icl-rocketry/payload_gimbal/motorboard/motorboard_back.png

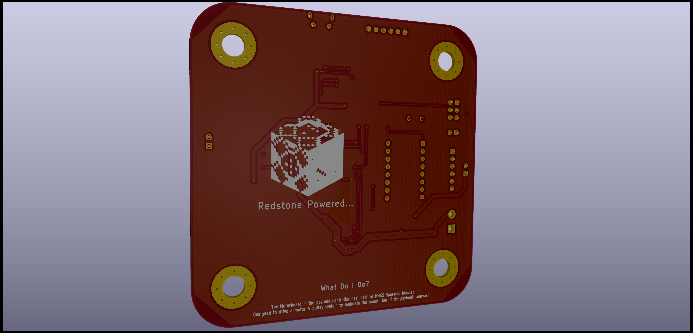
motorboard/motorboard_back.png
