icl-rocketry/payload_gimbal/motorboard/motorboard_cool.png

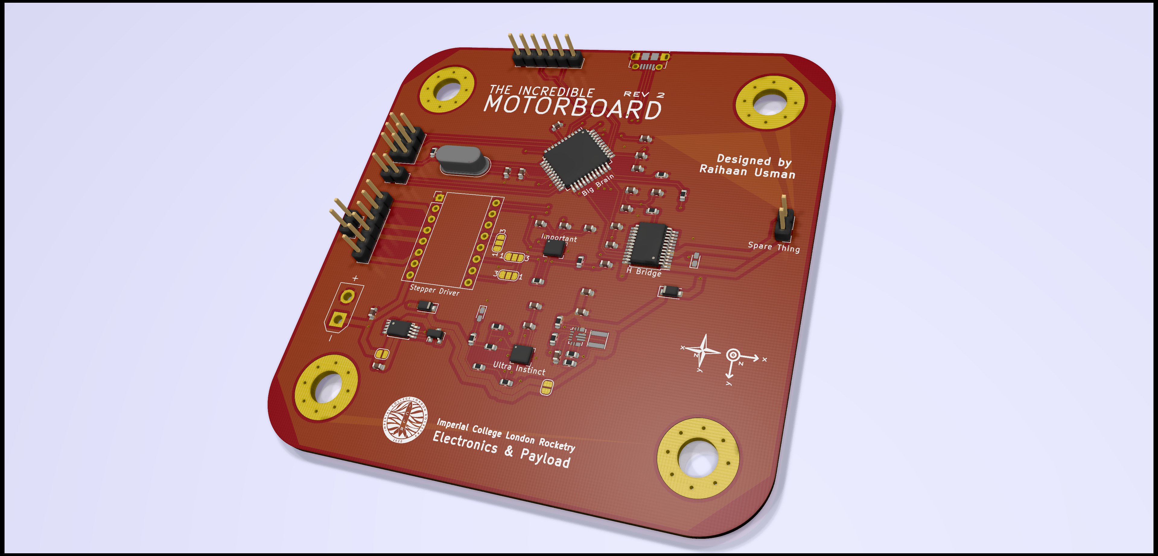
motorboard/motorboard_cool.png
