icl-rocketry/payload_gimbal/motorboard/References/microcontroller-sticker-pinout-atmega32u4.png

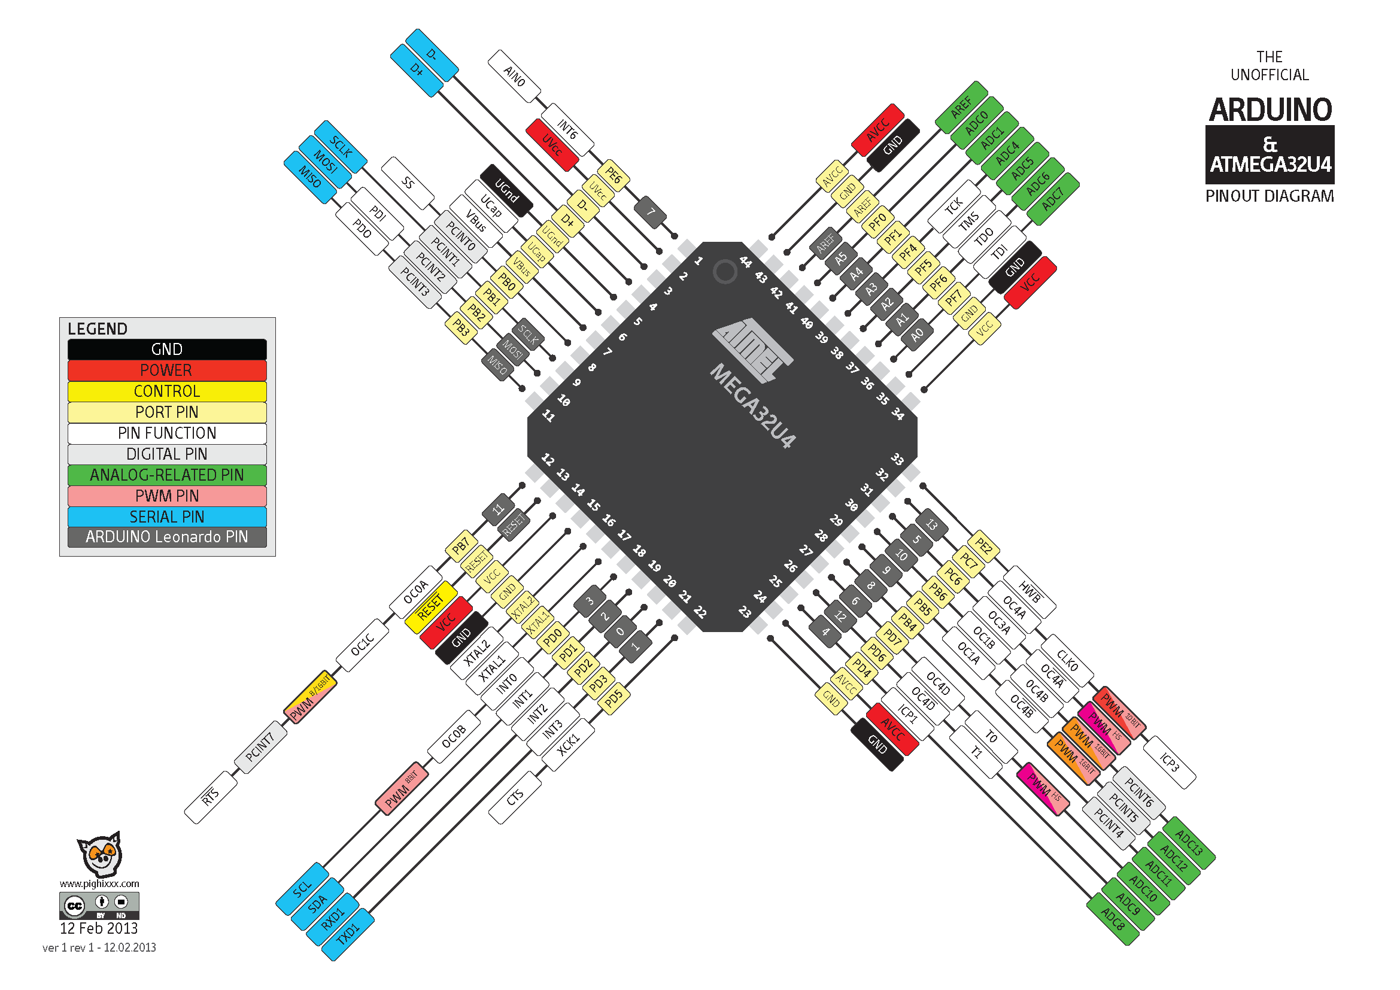
motorboard/References/microcontroller-sticker-pinout-atmega32u4.png
