icl-rocketry/payload_gimbal/motorboard/BOM for Motorboard.xlsx

Id | Designator | Package | Quantity | Designation | Unit Price | Farnell Order Code | Digikey Part Nr | URL | Total Price
4 | Y1 | Crystal_HC18-U_Vertical | 1 | 8MHz | £0.35 | 1842268 |  | https://uk.farnell.com/txc/9b-8-000maaj-b/xtal-8-000mhz-18pf-hc-49s/dp/1842268 | £0.35
9 | U2 | TQFP-44_10x10mm_P0.8mm | 1 | ATmega32U4-AU | £3.17 | 1748525 |  | https://uk.farnell.com/microchip/atmega32u4-au/mcu-8bit-megaavr-16mhz-tqfp-44/dp/1748525 | £3.17
12 | J2 | USB_Micro-B_Molex-105017-0001 | 1 | USB_B_Micro | £0.67 | 2293836 |  | https://uk.farnell.com/molex/105017-0001/usb-conn-2-0-micro-usb-type-b/dp/2293836 | £0.67
13 | U6,U5 | LGA-24L_3x3.5mm_P0.43mm | 2 | LSM9DS1 | £5.26 | 2532383 |  | https://uk.farnell.com/stmicroelectronics/lsm9ds1tr/mems-accelero-gyroscope-magneto/dp/2532383?st=LSM9DS1 | £10.52
14 | U4 | Texas_PowerVFQFN_15 | 1 | TPS63070 | £2.26 | 3007465 |  | https://uk.farnell.com/texas-instruments/tps63070rnmr/dc-dc-conv-buck-boost-2-4mhz-vqfn/dp/3007465?st=TPS63070 | £2.26
15 | U3 | TSSOP-8_4.4x3mm_P0.65mm | 1 | TPS2412PW | £2.47 | 2383048 |  | https://uk.farnell.com/texas-instruments/tps2412pw/o-ring-controller-3v-16-5v-tssop/dp/2383048?ost=TPS2412PW | £2.47
16 | U1 | SSOP-24_5.3x8.2mm_P0.65mm | 1 | TB6612FNG |  |  |  |  | £0.00
17 | R15,R14,R13,R12,R8,R5,R1 | R_0603_1608Metric | 7 | 10k | £0.01 | 1469748RL |  | https://uk.farnell.com/vishay/crcw060310k0fkea/res-10k-1-0-1w-0603-thick-film/dp/1469748RL?st=10k | £0.10
18 | R11 | R_0603_1608Metric | 1 | 150k | £0.01 | 1469759 |  | https://uk.farnell.com/vishay/crcw0603150kfkea/res-150k-1-0-1w-0603-thick-film/dp/1469759?st=150k | £0.01
19 | R10 | R_0603_1608Metric | 1 | 470k | £0.30 | 2331232 |  | https://uk.farnell.com/te-connectivity/cpf0603b470ke1/res-470k-0-1-0-063w-0603-thin/dp/2331232 | £0.30
20 | R9 | R_0603_1608Metric | 1 | 100k | £0.03 | 9234250 |  | https://uk.farnell.com/yageo/rc0805jr-07100kl/res-100k-5-0-125w-0805-thick-film/dp/9234250 | £0.03
21 | R7,R6 | R_0603_1608Metric | 2 | 470R | £0.02 | 9233334 |  | https://uk.farnell.com/yageo/rc0603jr-07470rl/res-470r-5-0-1w-0603-thick-film/dp/9233334 | £0.04
22 | R4 | R_0603_1608Metric | 1 | 10K | £0.01 | 1469748RL |  | https://uk.farnell.com/vishay/crcw060310k0fkea/res-10k-1-0-1w-0603-thick-film/dp/1469748RL?st=10k | £0.01
23 | R3,R2 | R_0603_1608Metric | 2 | 4k7 | £0.28 | 1577615 |  | https://uk.farnell.com/panasonic/era3aeb472v/res-4k7-0-1-0-1w-0603-thin-film/dp/1577615 | £0.56
24 | Q1 | SOT-23 | 1 | PMV20ENR | £0.30 |  | 1727-2301-1-ND | https://www.digikey.co.uk/product-detail/en/nexperia-usa-inc/PMV20ENR/1727-2301-1-ND/5395603 | £0.30
25 | L1 | L_Taiyo-Yuden_NR-30xx | 1 | 1u5 | £0.15 | 2211176 |  | https://uk.farnell.com/tdk/c1608x5r1e155k080ab/cap-1-5-f-25v-10-x5r-0603/dp/2211176 | £0.15
37 | D4,D3 | D_SOD-123F | 2 | D_Schottky | £0.12 |  | 1655-1926-1-ND | https://www.digikey.co.uk/product-detail/en/smc-diode-solutions/DSS13UTR/1655-1926-1-ND/8341868 | £0.24
40 | C22,C21,C19,C17,C16,C14,C10,C5 | C_0603_1608Metric | 10 | 100n | £0.05 | 1657913 |  | https://uk.farnell.com/avx/02016d104kat2a/cap-0-1-f-6-3v-10-x5r-0201/dp/1657913?st=100n | £0.49
41 | C20,C15,C12,C11,C9,C8,C1 | C_0603_1608Metric | 10 | 10u | £0.12 | 2456110 |  | https://uk.farnell.com/murata/grm188r61a106me69d/cap-10-f-10v-20-x5r-0603/dp/2456110 | £1.22
42 | C18,C13 | C_0603_1608Metric | 10 | 10n | £0.04 | 1657919 |  |  | £0.41
43 | C7 | C_0603_1608Metric | 10 | 2.2n | £0.08 | 1658869 (https://uk.farnell.com/avx/06035c223kat2a/cap-0-022-f-50v-10-x7r-0603/dp/1658869?st=0603%2022000pf) |  | https://uk.farnell.com/avx/06035c223kat2a/cap-0-022-f-50v-10-x7r-0603/dp/1658869?st=0603%2022000pf | £0.81
44 | C6 | C_0603_1608Metric | 10 | 1u | £0.08 | 2470448 (https://uk.farnell.com/murata/grm033r60j105mea2d/cap-1-f-6-3v-20-x5r-0201/dp/2470448) |  | https://uk.farnell.com/murata/grm033r60j105mea2d/cap-1-f-6-3v-20-x5r-0201/dp/2470448 | £0.85
45 | C4,C3 | C_0603_1608Metric | 10 | 22p | £0.02 | 2434636 (https://uk.farnell.com/murata/grm0335c1e220ja01d/cap-22pf-25v-5-c0g-np0-0201/dp/2434636) |  | https://uk.farnell.com/murata/grm0335c1e220ja01d/cap-22pf-25v-5-c0g-np0-0201/dp/2434636 | £0.16
46 | C2 | C_0603_1608Metric | 5 | 47u | £0.91 | 1572633 (https://uk.farnell.com/kemet/c0805c476m9pactu/cap-47-f-6-3v-20-x5r-0805/dp/1572633) |  | https://uk.farnell.com/kemet/c0805c476m9pactu/cap-47-f-6-3v-20-x5r-0805/dp/1572633 | £4.57
 |  |  |  |  |  |  |  | Total | £29.68
