icl-rocketry/payload_gimbal/motorboard/board.dxf

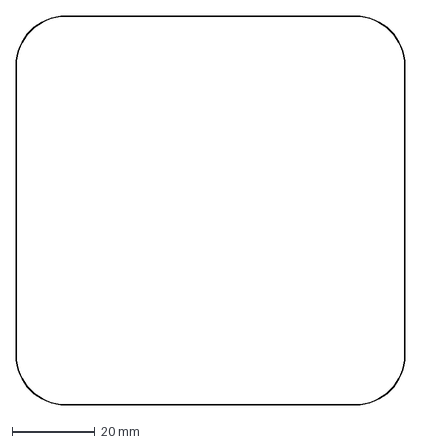
[picture p4: CAD file, 2020-03-26]
motorboard/board.dxf
94.0 x 94.0 mm
