icl-rocketry/payload_gimbal/motorboard/motorboard.kicad_pcb

## KiCad design motorboard/motorboard.kicad_pcb (2020-03-26)

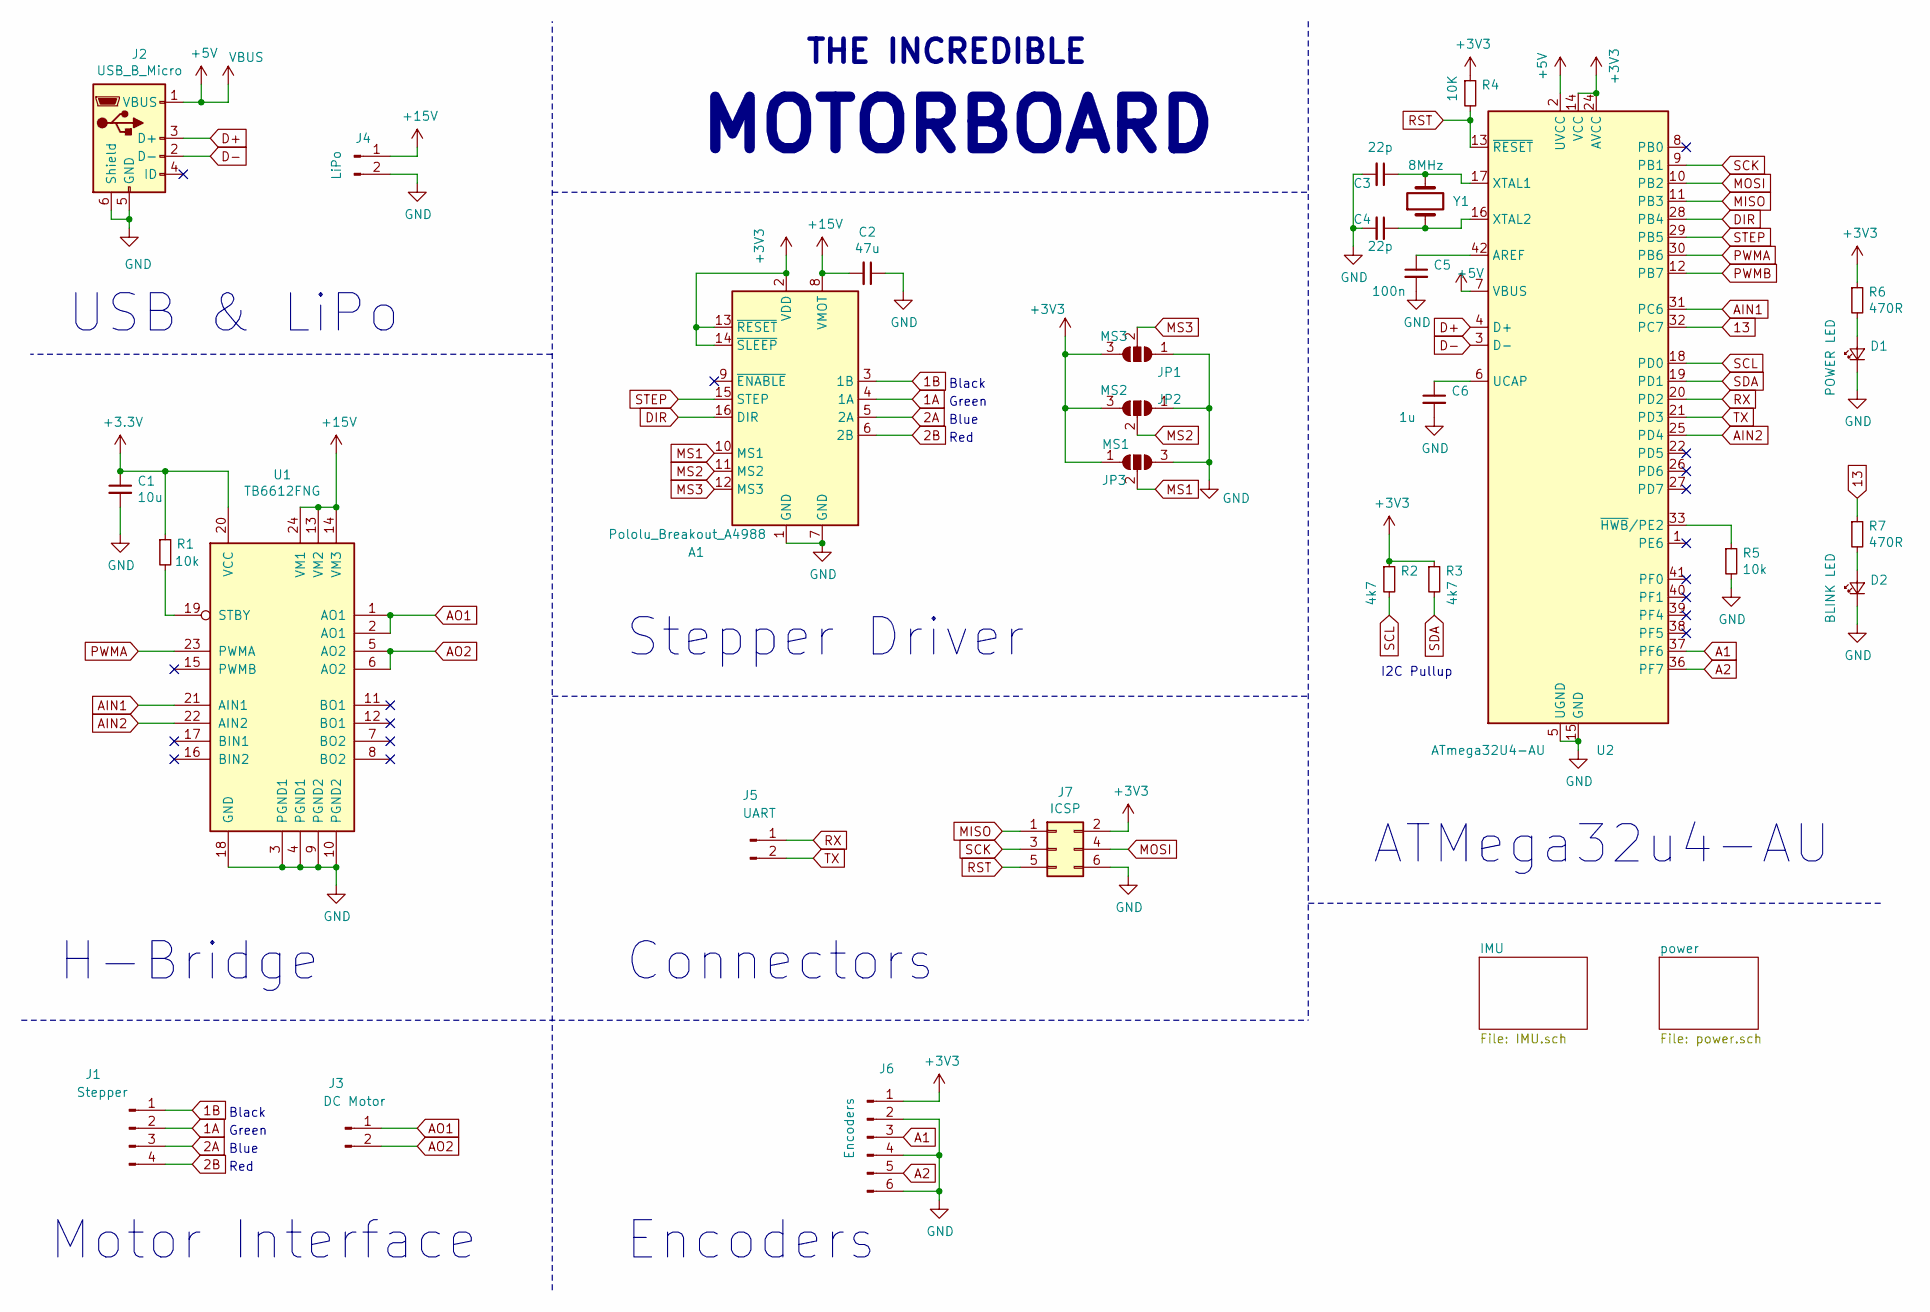
[picture p5: schematic motorboard.sch, The Incredible Motorboard]

Parts:
A1: Pololu_Breakout_A4988; Pololu_Breakout-16_15.2x20.3mm
C1: 10u; C_0603_1608Metric
C2: 47u; C_0603_1608Metric
C3, C4: 22p; C_0603_1608Metric
C5: 100n; C_0603_1608Metric
C6: 1u; C_0603_1608Metric
D1: POWER LED; D_0603_1608Metric_Castellated
D2: BLINK LED; D_0603_1608Metric_Castellated
J1: Stepper; PinHeader_1x06_P2.54mm_Vertical
J2: USB_B_Micro; USB_Micro-B_Molex-105017-0001
J3: DC Motor; PinHeader_1x02_P2.54mm_Vertical
J4: LiPo; AMASS_XT30UPB-F_1x02_P5.0mm_Vertical
J5: UART; PinHeader_1x02_P2.54mm_Vertical
J6: Encoders; PinHeader_1x06_P2.54mm_Vertical
J7: ICSP; PinHeader_2x03_P2.54mm_Vertical
JP1: MS3; SolderJumper-3_P1.3mm_Open_RoundedPad1.0x1.5mm_NumberLabels
JP2: MS2; SolderJumper-3_P1.3mm_Open_RoundedPad1.0x1.5mm_NumberLabels
JP3: MS1; SolderJumper-3_P1.3mm_Open_RoundedPad1.0x1.5mm_NumberLabels
R1, R5: 10k; R_0603_1608Metric
R2, R3: 4k7; R_0603_1608Metric
R4: 10K; R_0603_1608Metric
R6, R7: 470R; R_0603_1608Metric
U1: TB6612FNG; SSOP-24_5.3x8.2mm_P0.65mm
U2: ATmega32U4-AU; TQFP-44_10x10mm_P0.8mm
Y1: 8MHz; Crystal_HC49-4H_Vertical

Connections:
1A: A1.4 (1A), J1.2
1B: A1.3 (1B), J1.1
2A: A1.5 (2A), J1.3
2B: A1.6 (2B), J1.4
13: R7.1, U2.32 (PC7)
+5V: J2.1 (VBUS), U2.2 (UVCC), U2.7 (VBUS); also elsewhere on the board
+15V: A1.8 (VMOT), C2.2, J4.1, U1.13 (VM2), U1.14 (VM3), U1.24 (VM1); also elsewhere on the board
A1: J6.3, U2.37 (PF6)
A2: J6.5, U2.36 (PF7)
AIN1: U1.21 (AIN1), U2.31 (PC6)
AIN2: U1.22 (AIN2), U2.25 (PD4)
AO1: J3.1, U1.1 (AO1), U1.2 (AO1)
AO2: J3.2, U1.5 (AO2), U1.6 (AO2)
D+: J2.3 (D+), U2.4 (D+)
D-: J2.2 (D-), U2.3 (D-)
DIR: A1.16 (DIR), U2.28 (PB4)
GND: A1.1 (GND), A1.7 (GND), C1.2, C2.1, C3.2, C4.2, C5.2, C6.2, D1.1 (K), D2.1 (K), J2.5 (GND), J2.6 (Shield), J4.2, J6.2, J6.4, J6.6, J7.6, JP1.1 (A), JP2.1 (A), JP3.3 (B), R5.2, U1.3 (PGND1), U1.4 (PGND1), U1.9 (PGND2), U1.10 (PGND2), U1.18 (GND), U2.5 (UGND), U2.15 (GND), U2.23 (GND), U2.35 (GND), U2.43 (GND); also elsewhere on the board
MISO: J7.1, U2.11 (PB3)
MOSI: J7.4, U2.10 (PB2)
MS1: A1.10 (MS1), JP3.2 (C)
MS2: A1.11 (MS2), JP2.2 (C)
MS3: A1.12 (MS3), JP1.2 (C)
unnamed: C3.1, U2.17 (XTAL1), Y1.2
unnamed: C4.1, U2.16 (XTAL2), Y1.1
unnamed: C5.1, U2.42 (AREF)
unnamed: C6.1, U2.6 (UCAP)
unnamed: D1.2 (A), R6.2
unnamed: D2.2 (A), R7.2
unnamed: R1.2, U1.19 (STBY)
unnamed: R5.1, U2.33 (~HWB~/PE2)
PWMA: U1.23 (PWMA), U2.30 (PB6)
PWMB: U2.12 (PB7)
RST: J7.5, R4.2, U2.13 (~RESET)
RX: J5.1, U2.20 (PD2)
SCK: J7.3, U2.9 (PB1)
SCL: R2.2, U2.18 (PD0); also elsewhere on the board
SDA: R3.2, U2.19 (PD1); also elsewhere on the board
STEP: A1.15 (STEP), U2.29 (PB5)
TX: J5.2, U2.21 (PD3)

Notes on the sheet:
H-Bridge
USB & LiPo
ATMega32u4-AU
Motor Interface
Encoders
MOTORBOARD
THE INCREDIBLE
I2C Pullup
Stepper Driver
Black
Green
Blue
Red
Connectors

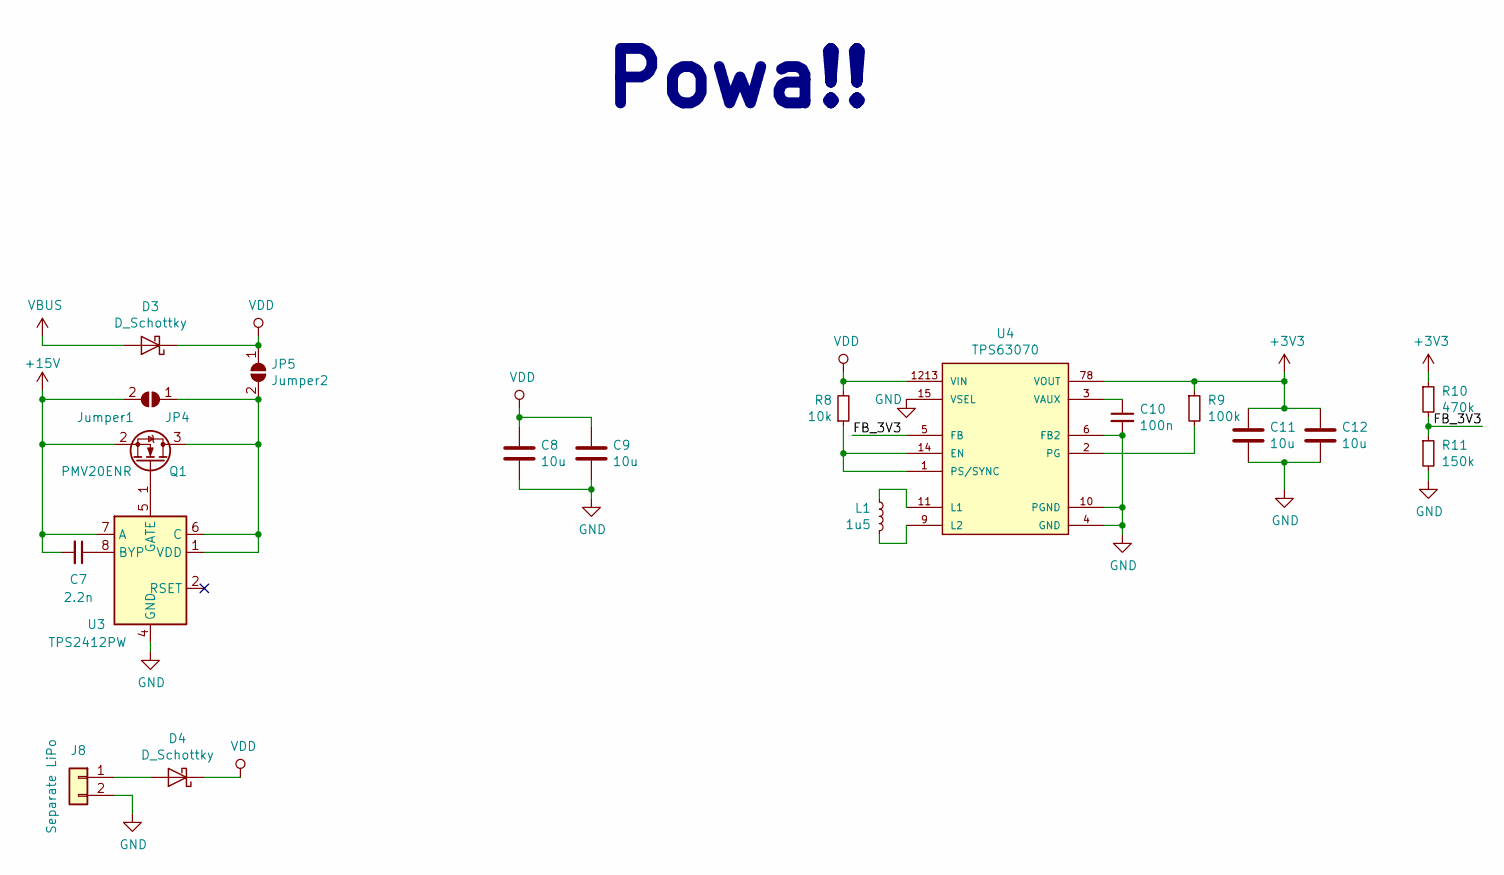
[picture p6: schematic power.sch]

Parts:
C7: 2.2n; C_0603_1608Metric
C8, C9, C11, C12: 10u; C_0603_1608Metric
C10: 100n; C_0603_1608Metric
D3, D4: D_Schottky; D_SOD-123F
J8: Separate LiPo; PinHeader_1x02_P2.54mm_Vertical
JP4: Jumper1; SolderJumper-2_P1.3mm_Open_RoundedPad1.0x1.5mm
JP5: Jumper2; SolderJumper-2_P1.3mm_Open_RoundedPad1.0x1.5mm
L1: 1u5; L_Taiyo-Yuden_NR-30xx
Q1: PMV20ENR; SOT-23
R8: 10k; R_0603_1608Metric
R9: 100k; R_0603_1608Metric
R10: 470k; R_0603_1608Metric
R11: 150k; R_0603_1608Metric
U3: TPS2412PW; TSSOP-8_4.4x3mm_P0.65mm
U4: TPS63070; Texas_PowerVFQFN_15

Connections:
+5V: D3.2 (A); also elsewhere on the board
+15V: C7.2, JP4.2 (B), Q1.2 (S), U3.7 (A); also elsewhere on the board
/power/FB_3V3: R10.2, R11.1, U4.5 (FB)
GND: C8.2, C9.2, C10.2, C11.2, C12.2, J8.2, R11.2, U3.3 (GND), U3.4 (GND), U4.4 (GND), U4.6 (FB2), U4.10 (PGND), U4.15 (VSEL); also elsewhere on the board
unnamed: C7.1, U3.8 (BYP)
unnamed: C10.1, U4.3 (VAUX)
unnamed: D4.2 (A), J8.1
unnamed: JP4.1 (A), JP5.2 (B), Q1.3 (D), U3.1 (VDD), U3.6 (C)
unnamed: L1.1, U4.9 (L2)
unnamed: L1.2, U4.11 (L1)
unnamed: Q1.1 (G), U3.5 (GATE)
unnamed: R8.1, U4.1 (PS/SYNC), U4.14 (EN)
unnamed: R9.2, U4.2 (PG)
VDD: C8.1, C9.1, D3.1 (K), D4.1 (K), JP5.1 (A), R8.2, U4.1213 (VIN)

Notes on the sheet:
Powa!!

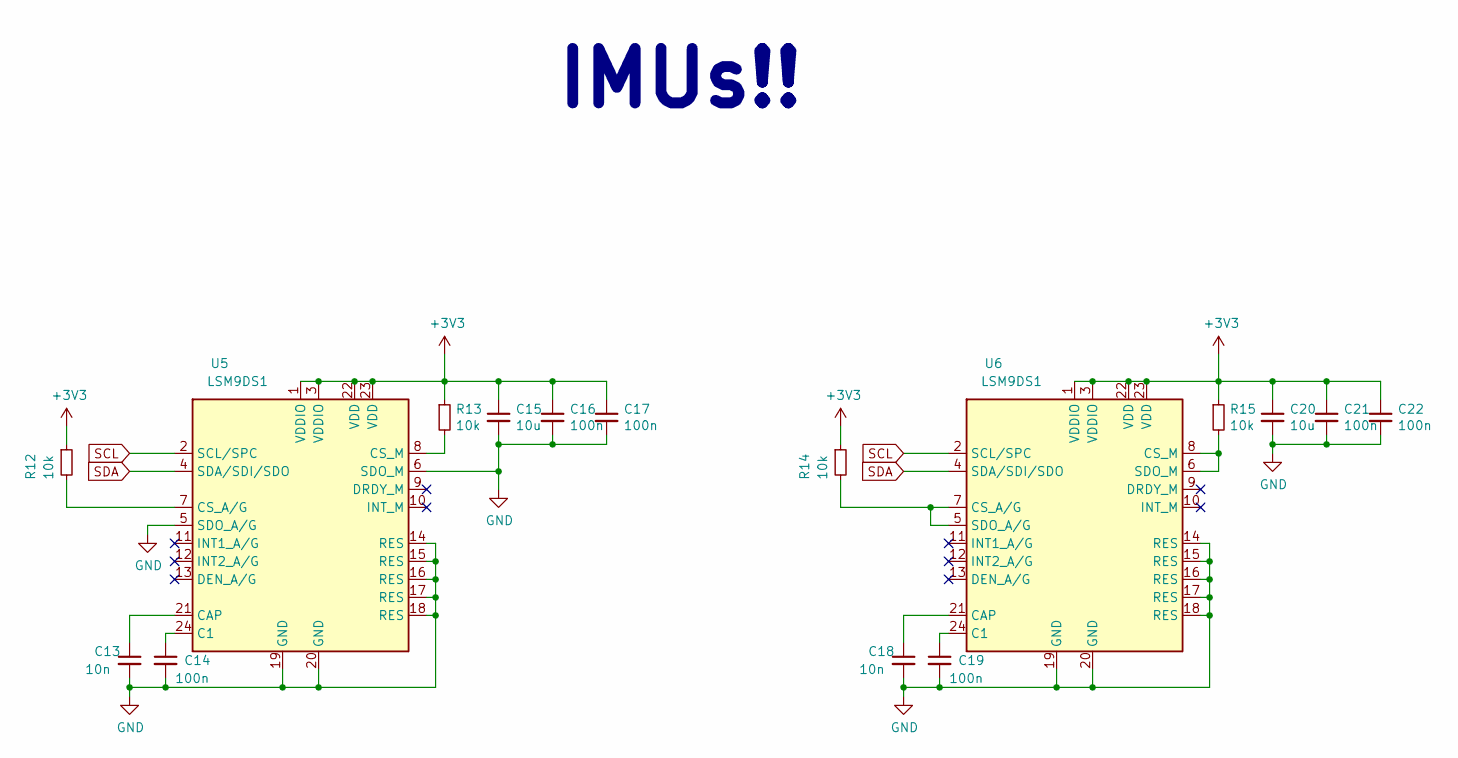
[picture p7: schematic IMU.sch, IMUs]

Parts:
C13, C18: 10n; C_0603_1608Metric
C14, C16, C17, C19, C21, C22: 100n; C_0603_1608Metric
C15, C20: 10u; C_0603_1608Metric
R12, R13, R14, R15: 10k; R_0603_1608Metric
U5, U6: LSM9DS1; LGA-24L_3x3.5mm_P0.43mm

Connections:
GND: C13.2, C14.2, C15.2, C16.2, C17.2, C18.2, C19.2, C20.2, C21.2, C22.2, U5.5 (SDO_A/G), U5.6 (SDO_M), U5.14 (RES), U5.15 (RES), U5.16 (RES), U5.17 (RES), U5.18 (RES), U5.19 (GND), U5.20 (GND), U6.14 (RES), U6.15 (RES), U6.16 (RES), U6.17 (RES), U6.18 (RES), U6.19 (GND), U6.20 (GND); also elsewhere on the board
unnamed: C13.1, U5.21 (CAP)
unnamed: C14.1, U5.24 (C1)
unnamed: C18.1, U6.21 (CAP)
unnamed: C19.1, U6.24 (C1)
unnamed: R12.2, U5.7 (CS_A/G)
unnamed: R13.2, U5.8 (CS_M)
unnamed: R14.2, U6.5 (SDO_A/G), U6.7 (CS_A/G)
unnamed: R15.2, U6.6 (SDO_M), U6.8 (CS_M)
SCL: U5.2 (SCL/SPC), U6.2 (SCL/SPC); also elsewhere on the board
SDA: U5.4 (SDA/SDI/SDO), U6.4 (SDA/SDI/SDO); also elsewhere on the board

Notes on the sheet:
IMUs!!

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
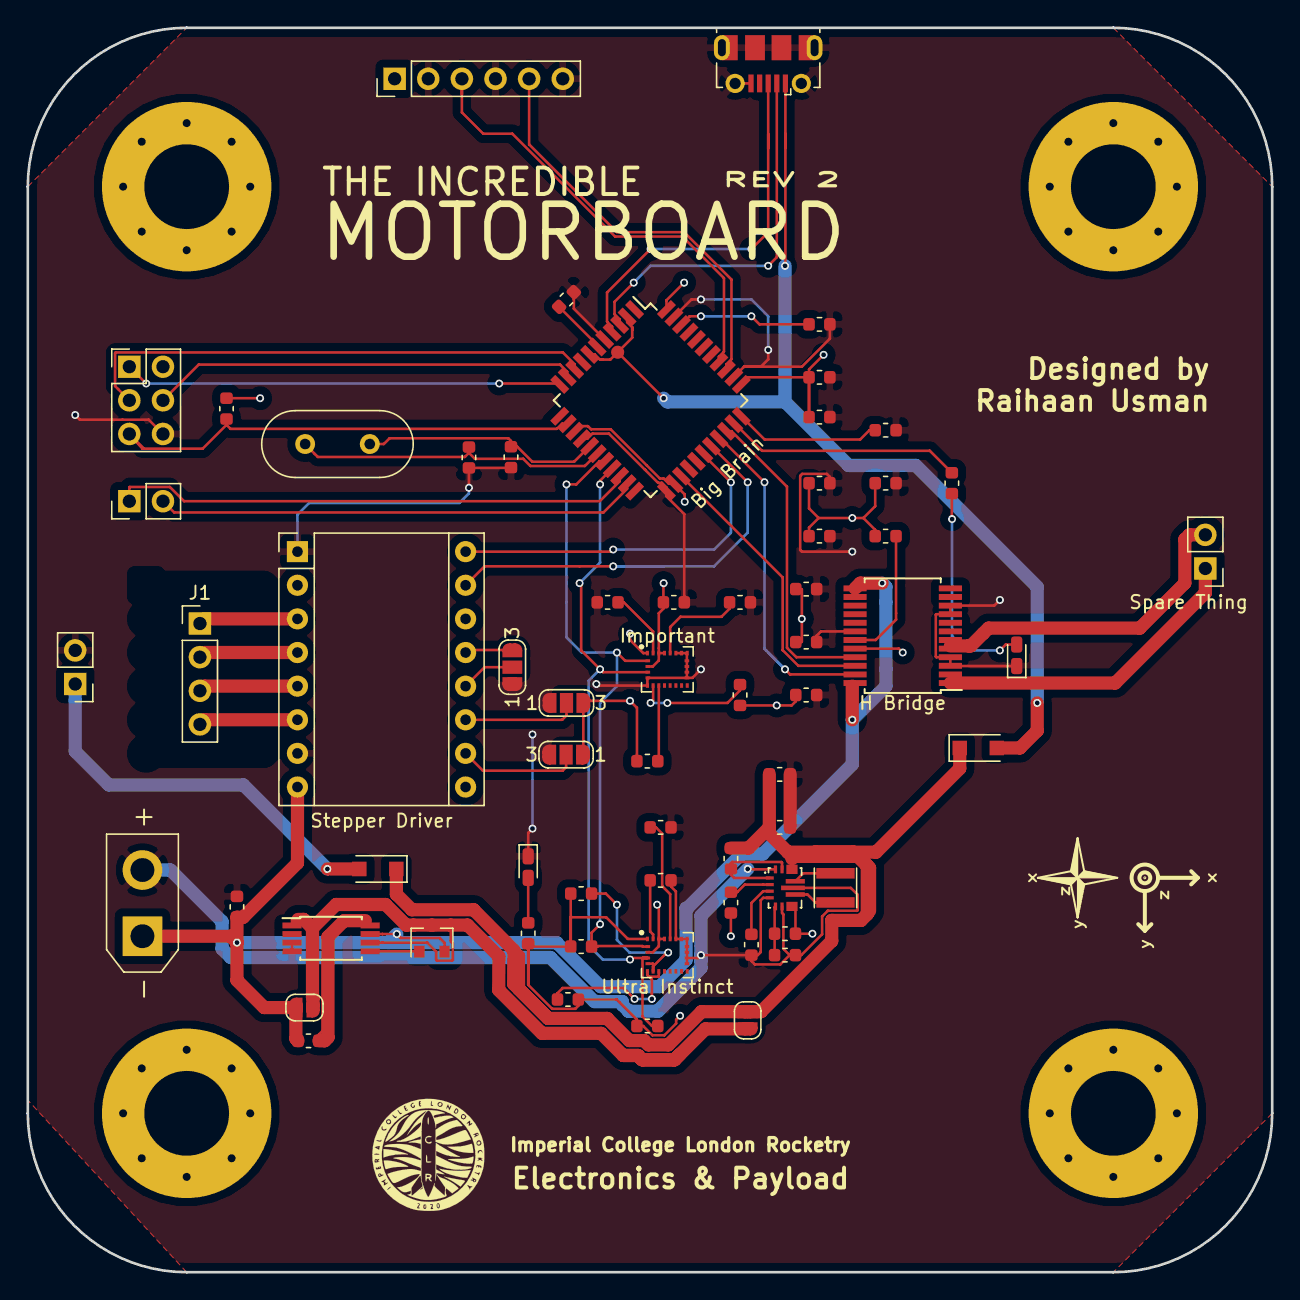
[picture p8: board motorboard.kicad_pcb from above]

Board: 2 copper layers, 94.0 x 94.0 mm, 68 parts (0 on the bottom side), 58 nets.

Other parts of the board:
BottomLeft: A_Hole; MountingHole_6.4mm_M6_Pad_Via
TopLeft: Hi; MountingHole_6.4mm_M6_Pad_Via
TopRight: Bye; MountingHole_6.4mm_M6_Pad_Via
e: Yeet; MountingHole_6.4mm_M6_Pad_Via
