icl-rocketry/payload_gimbal/(commit log)

2020-01-30 a new begining
    [motorboard.kicad_pcb, motorboard.sch]
2020-01-30 1st commit
    [motorboard.sch, powa.sch]
2020-01-30 update test
    [motorboard.sch]
2020-01-30 Still testing
    [powa.sch]
2020-01-31 Completed power things
    [amps.sch, motorboard.kicad_pcb, motorboard.sch, powa.sch, power.sch]
2020-01-31 Arduino is set up
    [motorboard.sch, power.sch]
2020-01-31 h bridge started
    [H-Bridge.sch, motorboard.sch, power.sch]
2020-01-31 basic h bridge complete
    [H-Bridge.sch, motorboard.sch]
2020-02-02 Switched to TB6612
    [H-Bridge.sch, motorboard.sch]
2020-02-02 H-bridge setup complete
    [H-Bridge.sch, motorboard.kicad_pcb, motorboard.sch, power.sch]
2020-02-02 Encoder started
    [motorboard.sch]
2020-02-04 Replaced ATMega328
    [motorboard.sch]
2020-02-09 update 09/02
    [motorboard.sch]
2020-02-12 Complete - Rev1
    [IMU.sch, motorboard.sch, power.sch]
2020-02-12 nearrrly there
    [IMU.sch, motorboard.sch, power.sch]
2020-02-13 tidying things
    [motorboard.sch]
2020-02-14 Debugged
    *Should* work
    [motorboard.sch, power.sch]
2020-02-16 PCB build started
    [IMU.sch, motorboard.kicad_pcb, motorboard.sch, power.sch]
2020-02-19 Sad day for GitHub
    [amps.sch, motorboard.sch]
2020-02-19 GitHub works again!
    [motorboard.kicad_pcb, motorboard.sch, power.sch]
2020-02-20 PCB nearly done!
    [motorboard.kicad_pcb]
2020-02-20 Literally the last few nets...
    [motorboard.kicad_pcb]
2020-02-20 It broke again
    [motorboard.kicad_pcb, motorboard.sch]
2020-02-21 ready for fab
    [motorboard.kicad_pcb, motorboard.sch]
2020-02-22 Added BOM
    [BOM for Motorboard.xlsx]
2020-03-11 neater again!
    [motorboard.kicad_pcb]
2020-03-19 noob error fixed
    [motorboard.kicad_pcb, motorboard.sch]
2020-03-20 forgot something crucial...
    [motorboard.kicad_pcb]
2020-03-20 Stepper test sketch added
2020-03-20 moved things around, looks cleaner
    [motorboard.kicad_pcb]
2020-03-26 rev2 started
    [motorboard.kicad_pcb, motorboard.sch, power.sch]
2020-03-26 nicer board!
    [motorboard.kicad_pcb]
2020-03-26 Rev2 complete
    [board.dxf, motorboard.kicad_pcb]
2020-03-26 4 pin header for stepper
    [motorboard.kicad_pcb, motorboard.sch]
